joshatron/Moon-Phases/pictures/moon_back_panel_batteries_cut_out.jpg

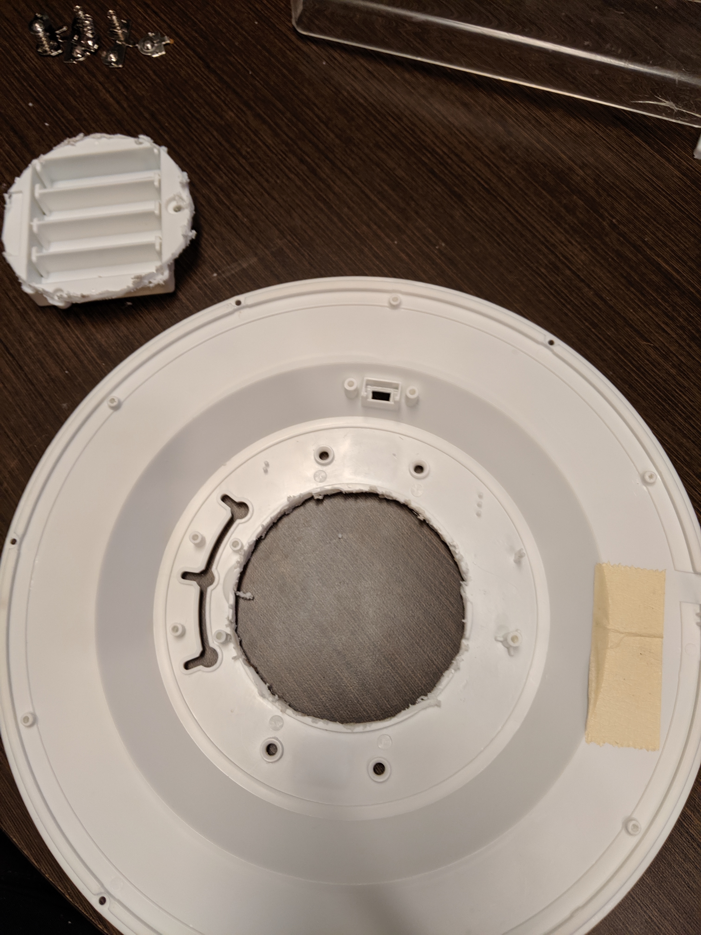
pictures/moon_back_panel_batteries_cut_out.jpg
