joshatron/Moon-Phases/(commit log)

2019-06-02 Added comments and button offset
2019-06-09 Keep track of full moon cycle separately, add picture of new pin config
2019-06-11 Redid state change and button management to main loop, added switch directions
